cameron5906/field4-rover/docs/hardware/diagrams/01_system_architecture.png

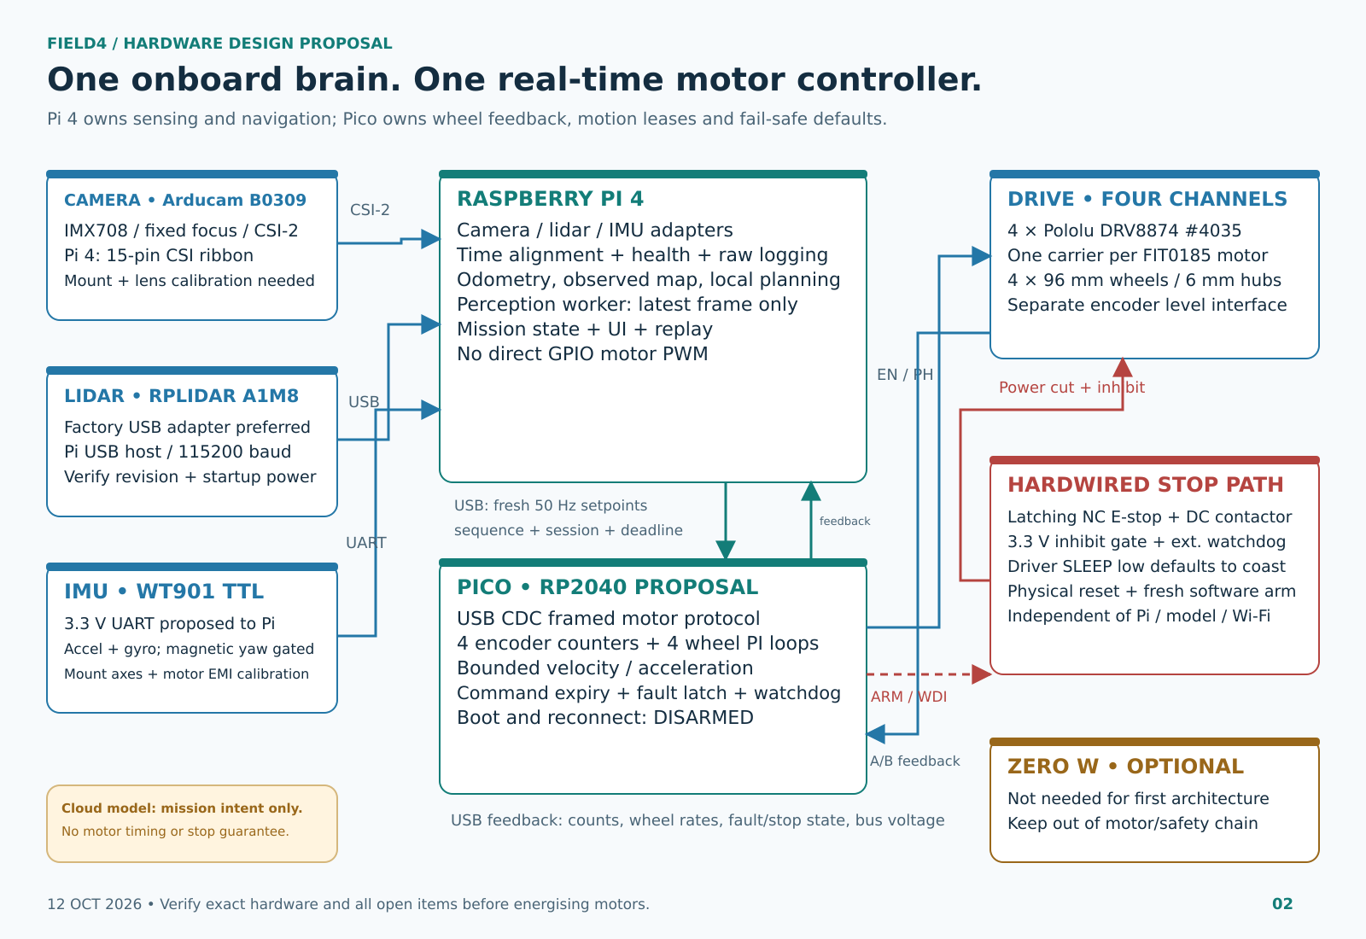
docs/hardware/diagrams/01_system_architecture.png
