cameron5906/field4-rover/docs/hardware/diagrams/02_power_and_stop.png

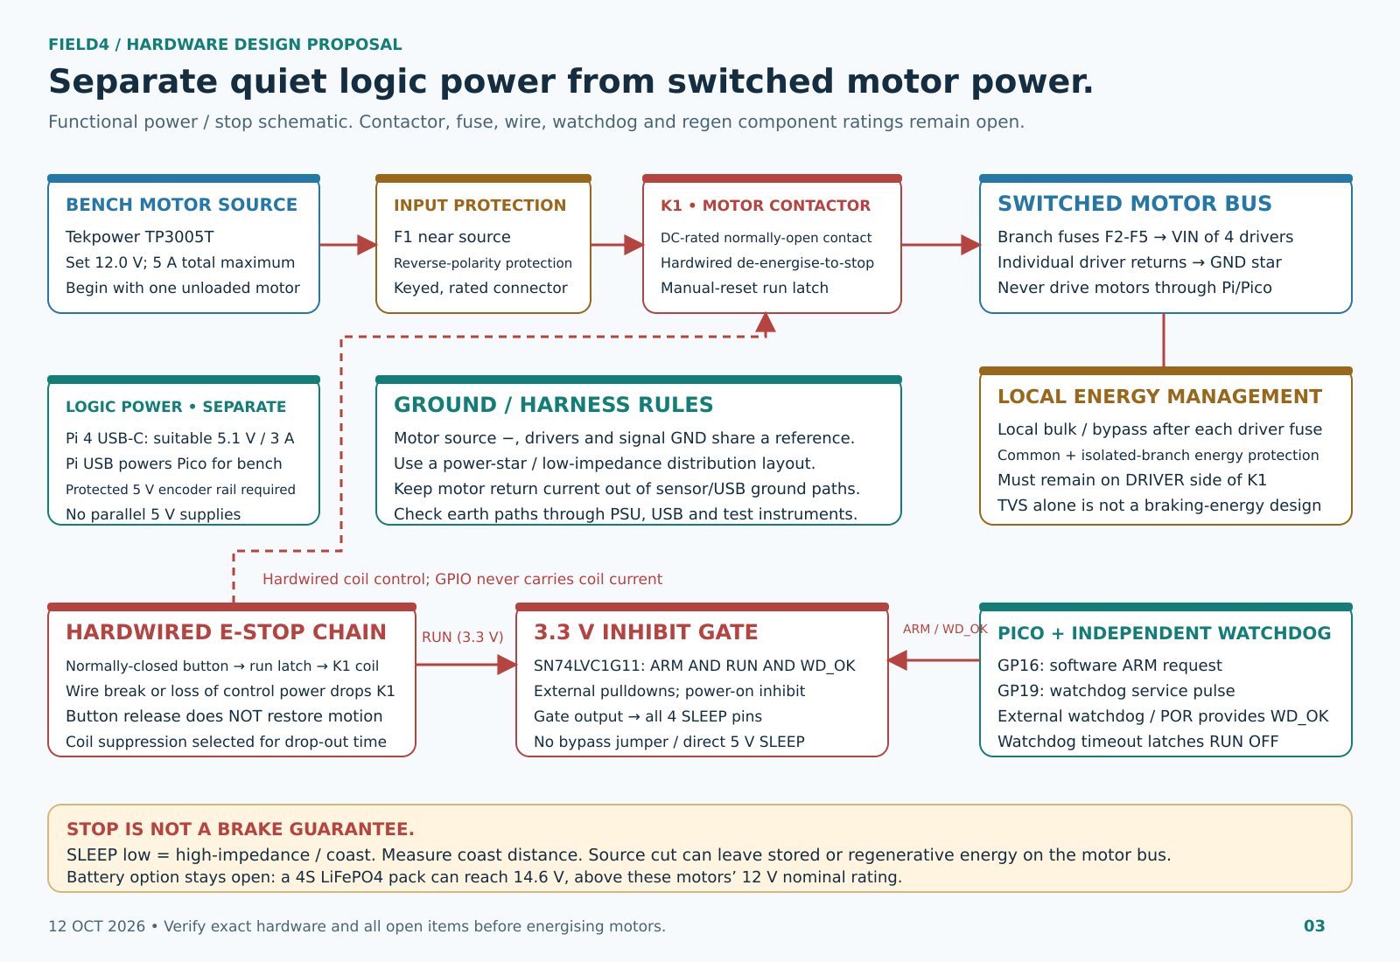
docs/hardware/diagrams/02_power_and_stop.png
