cameron5906/field4-rover/docs/hardware/diagrams/03_pinmap_and_motor_cell.png

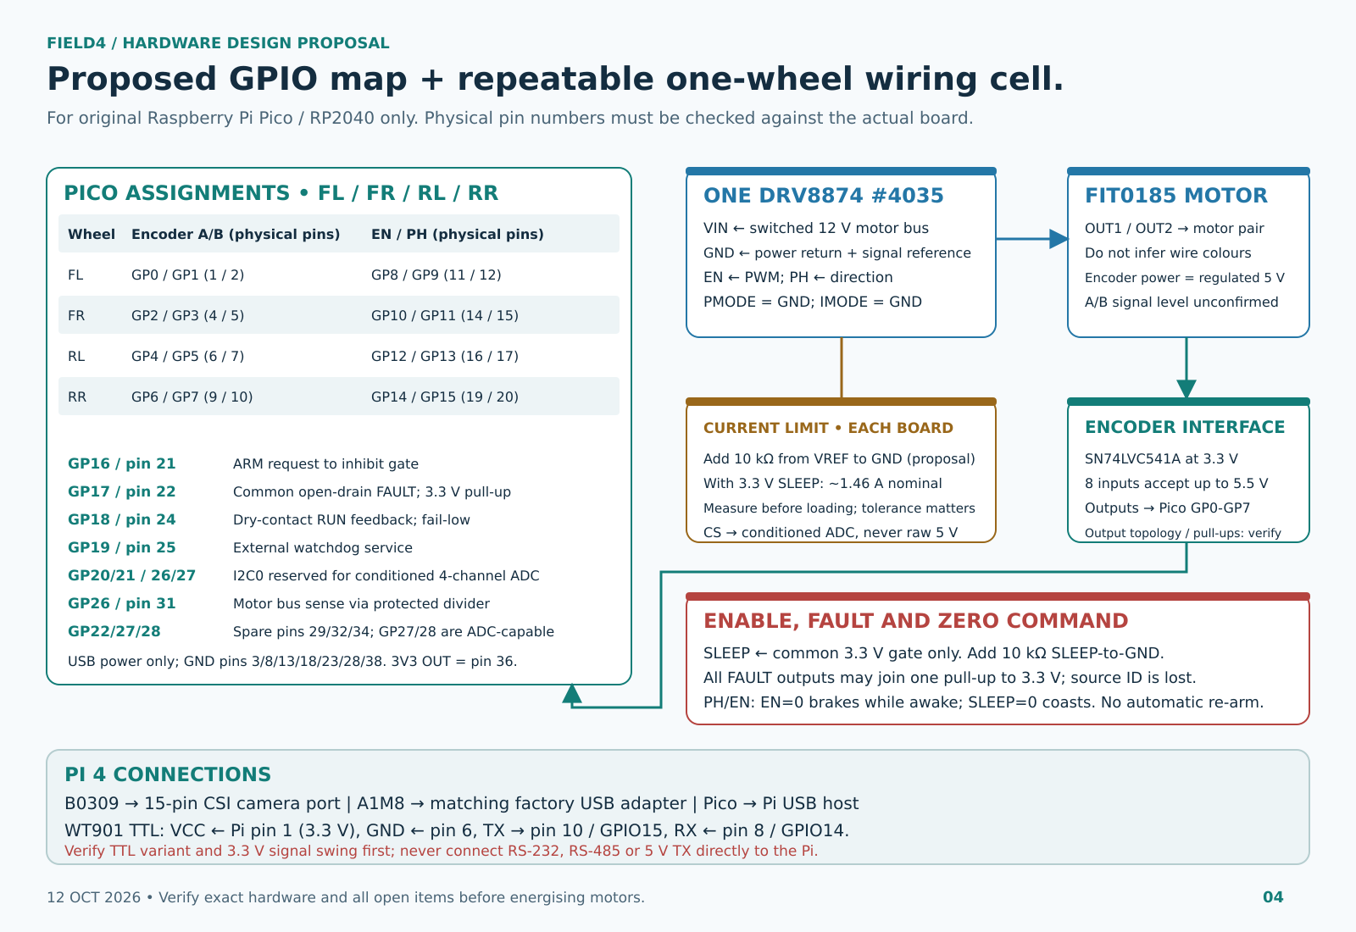
docs/hardware/diagrams/03_pinmap_and_motor_cell.png
