cameron5906/field4-rover/docs/manual/renders/electronics.png

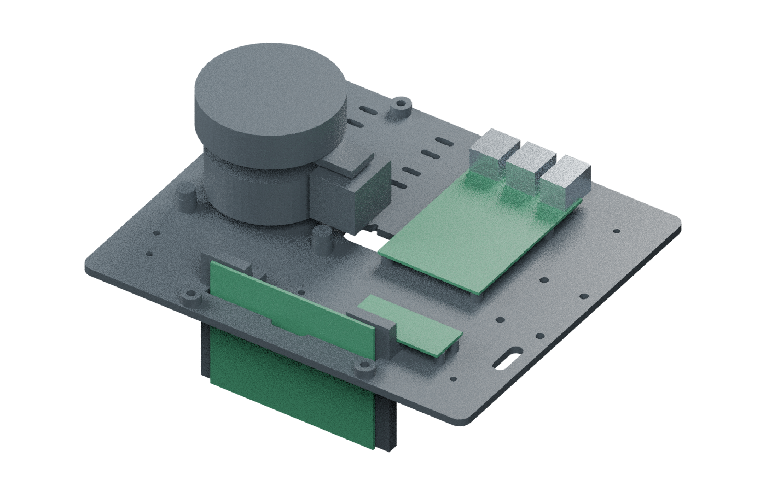
docs/manual/renders/electronics.png
