cameron5906/field4-rover/docs/manual/renders/parts.png

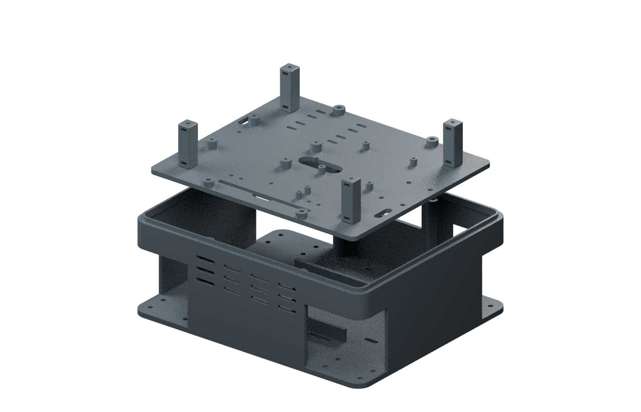
docs/manual/renders/parts.png
