cameron5906/field4-rover/cad/stl/conditional/B10_motor_mount_FR.stl

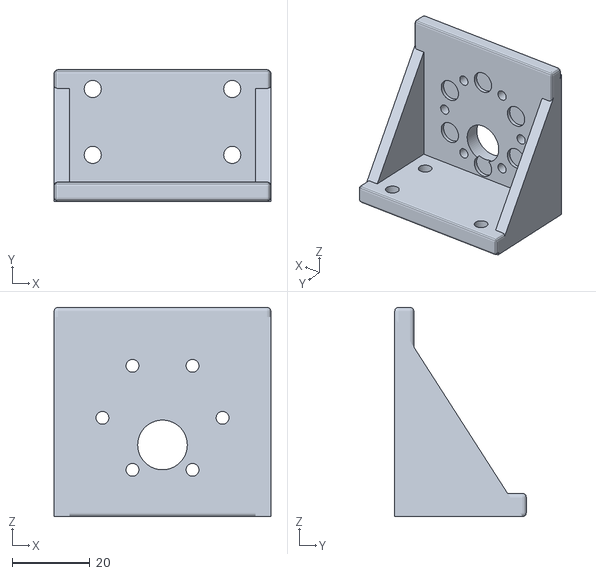
[picture p7: CAD file, 2026-10-19]
cad/stl/conditional/B10_motor_mount_FR.stl
56.0 x 34.0 x 54.0
