cameron5906/field4-rover/cad/stl/coupons/T01_motor_face_coupon.stl

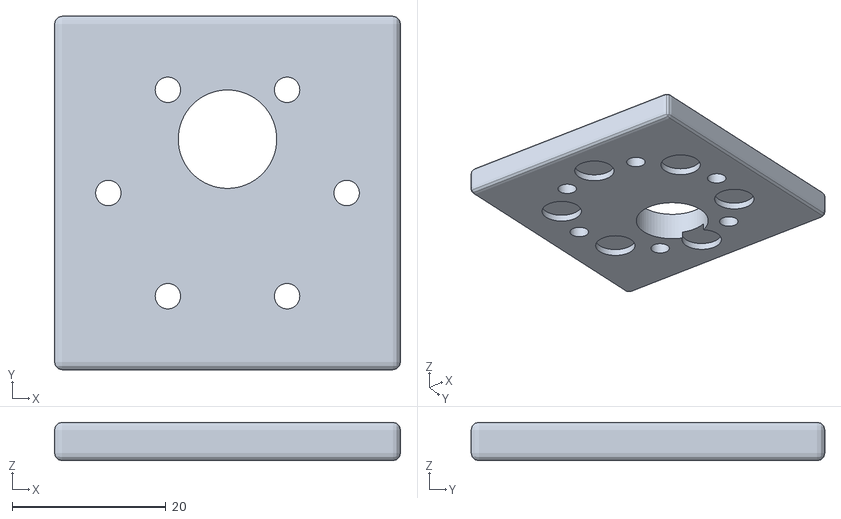
[picture p8: CAD file, 2026-10-19]
cad/stl/coupons/T01_motor_face_coupon.stl
45.0 x 46.0 x 5.00
