cameron5906/field4-rover/cad/stl/current/B05_lid_pillar_FL.stl

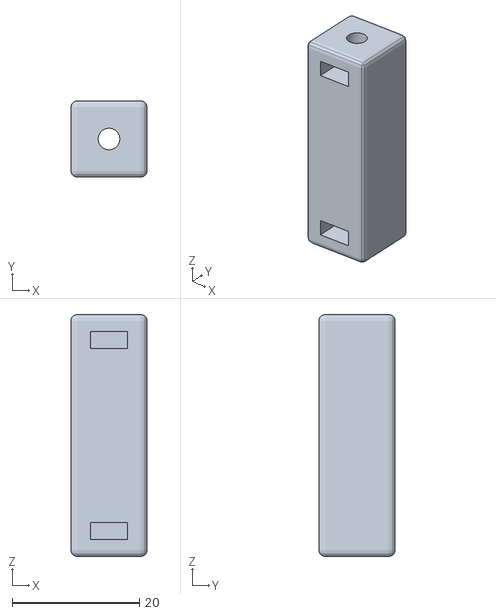
[picture p9: CAD file, 2026-10-19]
cad/stl/current/B05_lid_pillar_FL.stl
12.0 x 12.0 x 38.0
