cameron5906/field4-rover/cad/stl/coupons/T09_A1M8_four_foot_coupon.stl

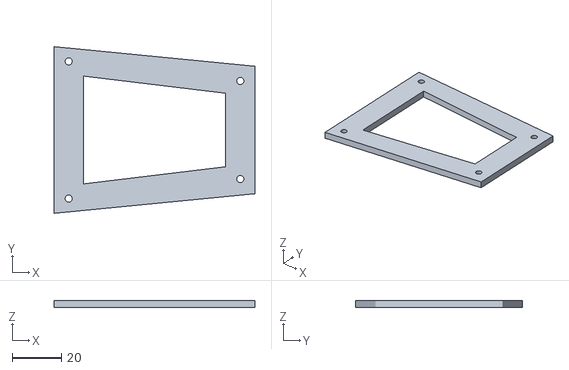
[picture p10: CAD file, 2026-10-19]
cad/stl/coupons/T09_A1M8_four_foot_coupon.stl
82.0 x 68.0 x 3.00
