cameron5906/field4-rover/cad/stl/coupons/T03_bracket_floor_coupon.stl

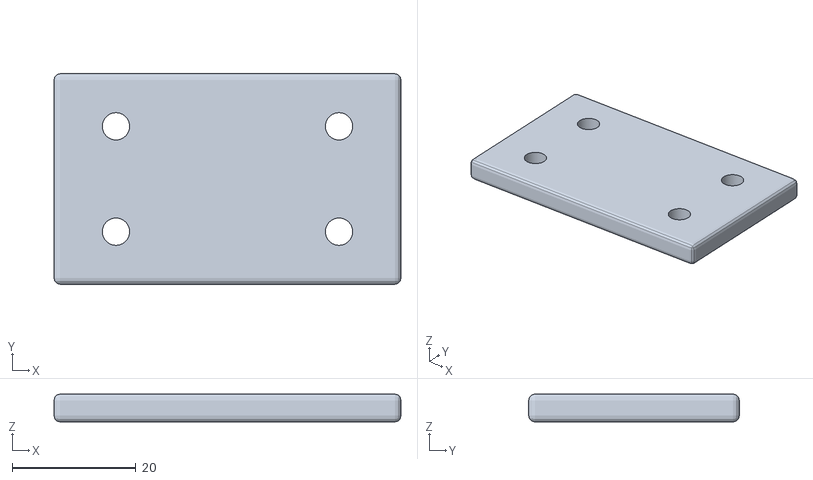
[picture p11: CAD file, 2026-10-19]
cad/stl/coupons/T03_bracket_floor_coupon.stl
56.0 x 34.0 x 4.50
