cameron5906/field4-rover/cad/stl/conditional/B07_camera_carrier.stl

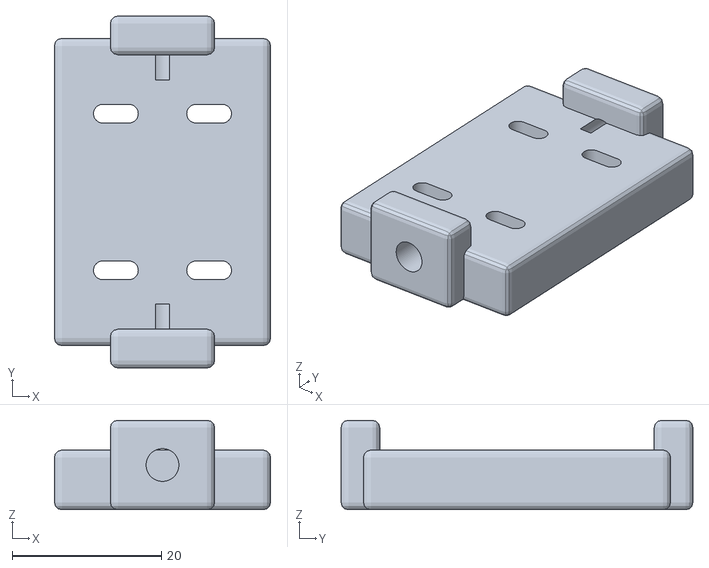
[picture p12: CAD file, 2026-10-19]
cad/stl/conditional/B07_camera_carrier.stl
29.0 x 47.2 x 12.0
