cameron5906/field4-rover/cad/stl/coupons/T07_lid_tongue_coupon.stl

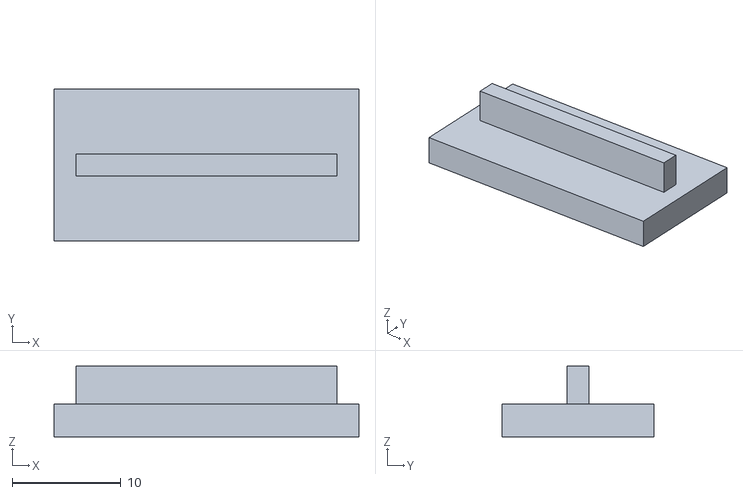
[picture p13: CAD file, 2026-10-19]
cad/stl/coupons/T07_lid_tongue_coupon.stl
28.0 x 14.0 x 6.50
