cameron5906/field4-rover/cad/stl/current/C04_A1M8_rearranged_shelf_PROTOTYPE.stl

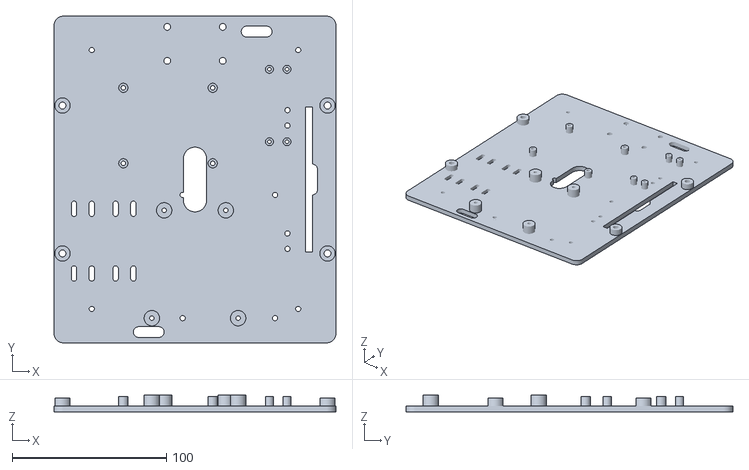
[picture p14: CAD file, 2026-10-19]
cad/stl/current/C04_A1M8_rearranged_shelf_PROTOTYPE.stl
183.0 x 212.0 x 11.0
