cameron5906/field4-rover/cad/stl/coupons/T02_fastener_clearance_coupon.stl

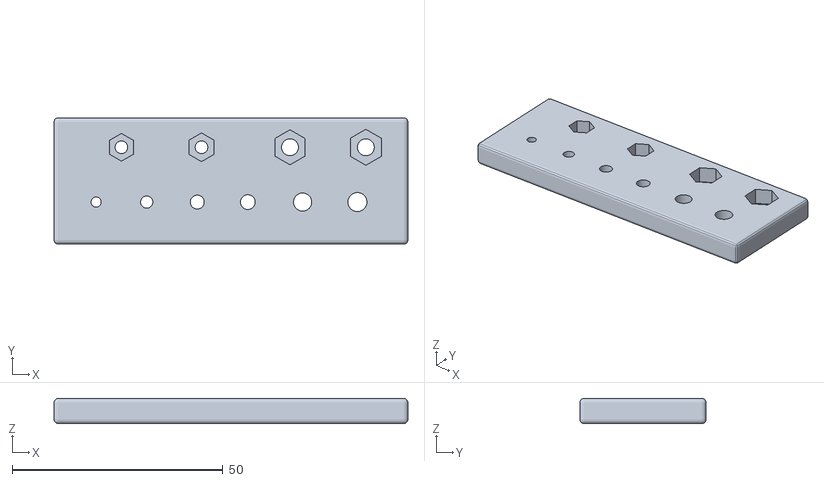
[picture p15: CAD file, 2026-10-19]
cad/stl/coupons/T02_fastener_clearance_coupon.stl
84.0 x 30.0 x 6.00
