cameron5906/field4-rover/cad/stl/current/B01_lower_tub.stl

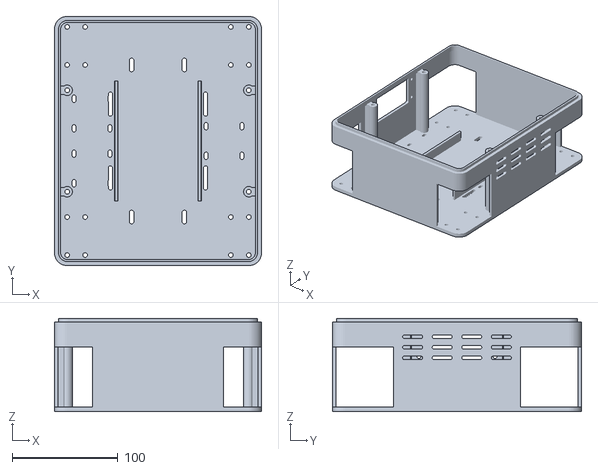
[picture p16: CAD file, 2026-10-19]
cad/stl/current/B01_lower_tub.stl
196.0 x 236.0 x 88.5
