cameron5906/field4-rover/cad/stl/conditional/C16_controller_hanger_rear.stl

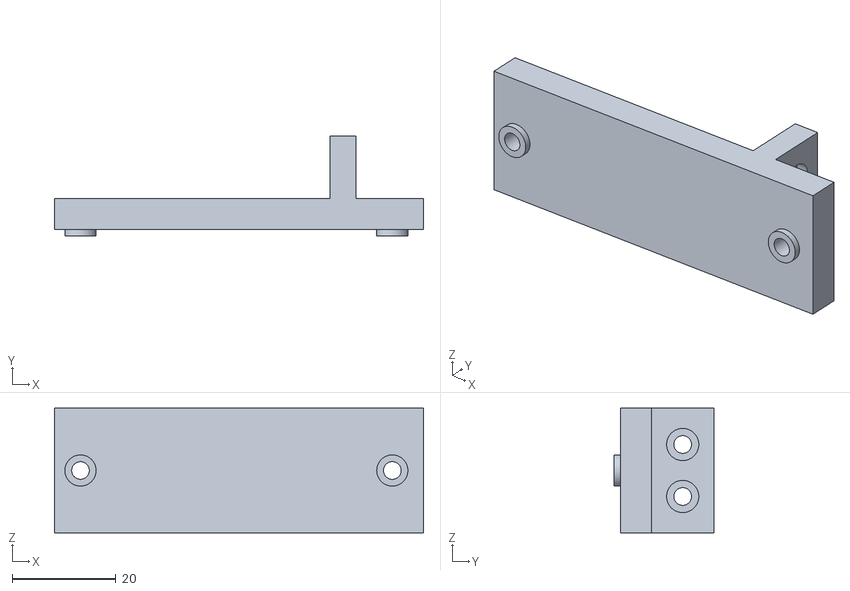
[picture p17: CAD file, 2026-10-19]
cad/stl/conditional/C16_controller_hanger_rear.stl
71.0 x 19.2 x 24.0
