cameron5906/field4-rover/cad/stl/coupons/T04_camera_pattern_coupon.stl

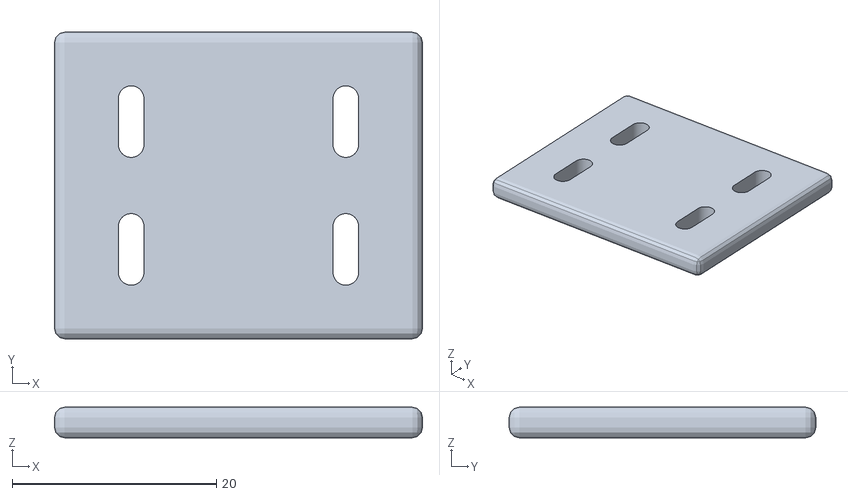
[picture p18: CAD file, 2026-10-19]
cad/stl/coupons/T04_camera_pattern_coupon.stl
36.0 x 30.0 x 3.00
