cameron5906/field4-rover/cad/stl/conditional/B06_camera_fork.stl

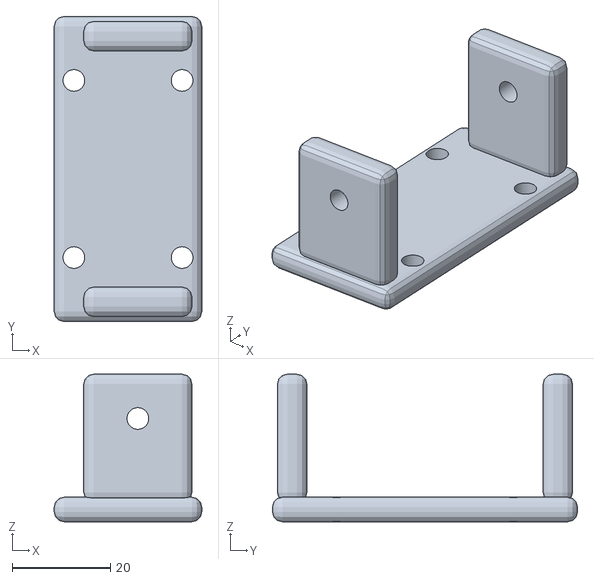
[picture p19: CAD file, 2026-10-19]
cad/stl/conditional/B06_camera_fork.stl
30.0 x 62.0 x 30.0
