cameron5906/field4-rover/cad/stl/current/B09_side_switch_panel_BLANK.stl

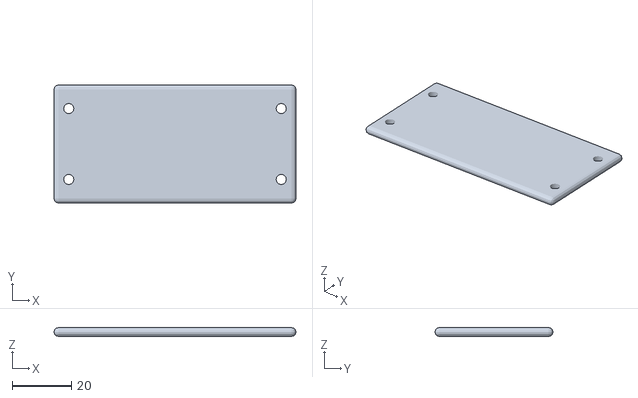
[picture p20: CAD file, 2026-10-19]
cad/stl/current/B09_side_switch_panel_BLANK.stl
82.0 x 40.0 x 3.00
