cameron5906/field4-rover/cad/stl/coupons/T06_lid_clearance_coupon.stl

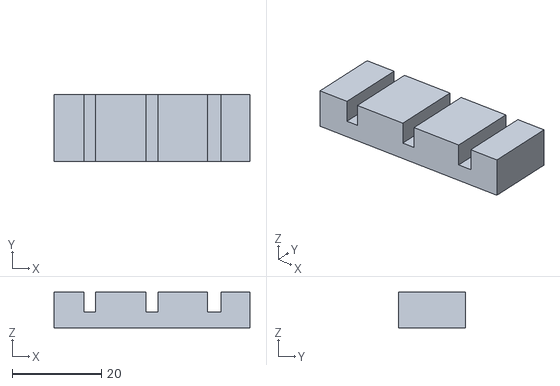
[picture p21: CAD file, 2026-10-19]
cad/stl/coupons/T06_lid_clearance_coupon.stl
44.0 x 15.0 x 8.00
