cameron5906/field4-rover/(list of files, cad)

Other CAD files:
cad/stl/conditional/B10_motor_mount_FL.stl
cad/stl/conditional/B10_motor_mount_RL.stl
cad/stl/conditional/C16_controller_hanger_front.stl
cad/FIELD4_Mechanical_Subset.blend
cad/stl/coupons/T05_M3_captive_nut_coupon.stl
