cameron5906/field4-rover/docs/manual/FIELD4_Beginner_Visual_Build_Manual.pdf

FIELD4 / BUILD MANUAL

YOUR FIRST BUILD
A robot, one clear step at a time.

FIELD4 • Recessed-LiDAR prototype • Public edition with asset holds

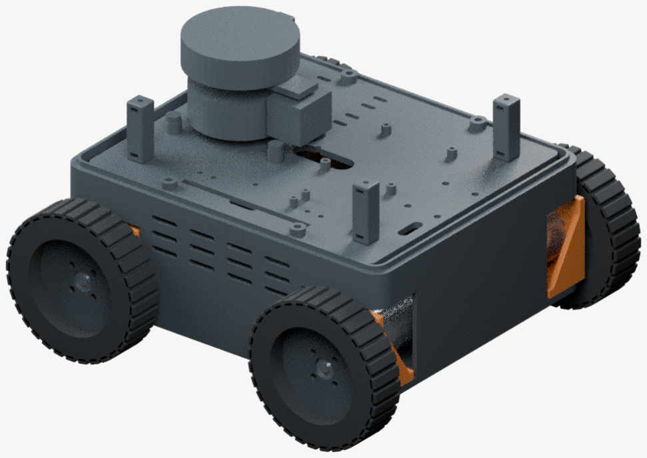
[picture p22: figure]

PROTOTYPE • Power off for every step | 01

SENSOR: SCHEMATIC PROXY / NOT FOR FIT

# A beginner-friendly mechanical build guide

Public CAD views show an open chassis and a schematic sensor. The current C02 lid and T10 aperture gauge are withheld pending reference-model redistribution clarification.

READ THIS FIRST

This public package is incomplete for the intended C02 + C04 build. Do not infer lid or aperture geometry from the pictures, or use a substitute lid. Keep all power disconnected; this prototype is uncommissioned.

Build facts retained: B01 tub + B05 pillars + B09 blank + matched C02/C04. C02 and T10 files are withheld; B08 remains excluded.

01 / PLAN YOUR SESSION

# Check what is ready

Inspect the actual parts on your bench before opening a fastener bag.

Component | Check before use | Build gate
4 Pololu DRV8874 drivers | Confirm exact board revision and condition | No wiring or mounting approval is established by this guide.
4 goBILDA 96 mm Hogback wheels + 4 Sonic 6 mm hubs | Inspect wheels, hub bores and clamp access | Verify shaft engagement and clearance with the actual motors.
Mechanical fasteners | Count and measure against page 3 | Do not infer screw length or washer thickness from appearance.
4 DFRobot FIT0185 motors | Check the actual gearbox face, shaft and lead exit | Pass the motor coupon and one-corner fit checks first.
Printed parts + A1M8 LiDAR | C02 lid and T10 gauge are withheld | The public package cannot complete the intended lid/aperture fit gates.
Battery, power protection and wiring | Electrical design is uncommissioned | Do not connect any power source.

TODAY’S STOPPING POINT

Prepare only the available power-off mechanical checks. C02 lid and T10 gauge are withheld; stop at any dependent step. Keep the shelf removable and do not improvise a replacement lid or aperture.

02 / SORT THE HARDWARE

# Make five small parts trays

Required quantities for these mechanical joints only; other assemblies need separate checks.

Tray / job | Required for this build | Reference SKU
LiDAR final mount | 4 M2.5×16 screws + 4 M2.5 thin flat washers | MSP2.5X16SS WF2.5X5SS
Shelf to tub | 4 M4×100 SOCKET-head screws + 8 M4 flats + 4 M4 split washers + 4 M4 plain nuts | BSH4X100 WF4X8SS WL4SS; NR4SS
Pillars + lid | 8 M3×12 button screws + 8 M3 plain nuts; no flat washers in these stacks | SB3X12SS NR3SS
Switch BLANK | 4 M3×12 button screws + 8 M3 thin flats + 4 M3 plain nuts | SB3X12SS; NR3SS WF3X6SS
Shared M3 totals | 12 M3×12 screws + 12 M3 plain nuts across the two jobs above | Verify actual sizes before assembly

The three specified thin flat-washer sizes are 0.5 mm thick. Flat washer = smooth ring. Split washer = ring with a split. Plain nut = no nylon locking ring. Do not substitute taller locking nuts in printed pockets. SKU references identify BelMetric parts; verify specifications before use.

ADDITIONAL HARDWARE REQUIRED

T09 needs separate M2.5×6 screws; they are not in the list above. Motor, wheel, electronics, controller-hanger and camera fasteners also require separate verification.

03 / LEARN THE PARTS

# This is how the body fits together

Exploded public parts view. The intended C02 lid is withheld and not shown.

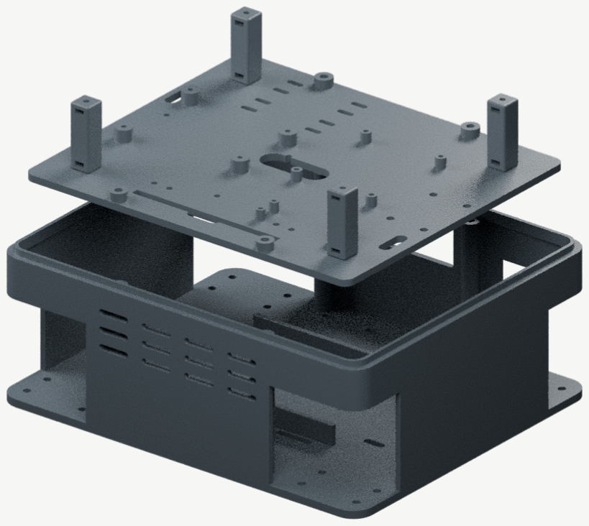
[picture p23: figure]

SHOWN: four B05 pillars + C04 shelf → B01 tub. C02 lid is withheld.

1. The intended C02 lid is removable; its file is withheld. The LiDAR and shelf are carried by the lower body rather than the lid.
2. FL / FR / RL / RR mean front-left / front-right / rear-left / rear-right, as the robot faces forward. Front is the camera end; the LiDAR sits toward the rear.
3. C02 and C04 remain the intended matched pair, but C02 is not distributed here. Do not substitute older B02/B04 parts or invent a lid from this illustration. Leave B08 out.

BEGINNER TIP

Lay out labeled parts before fastening them. A dry fit means putting parts together gently, without power and without fully tightening screws.

04 / PREPARE

# Get the bench ready

Keep small screws in trays. Put electronics on a clean, nonconductive surface.

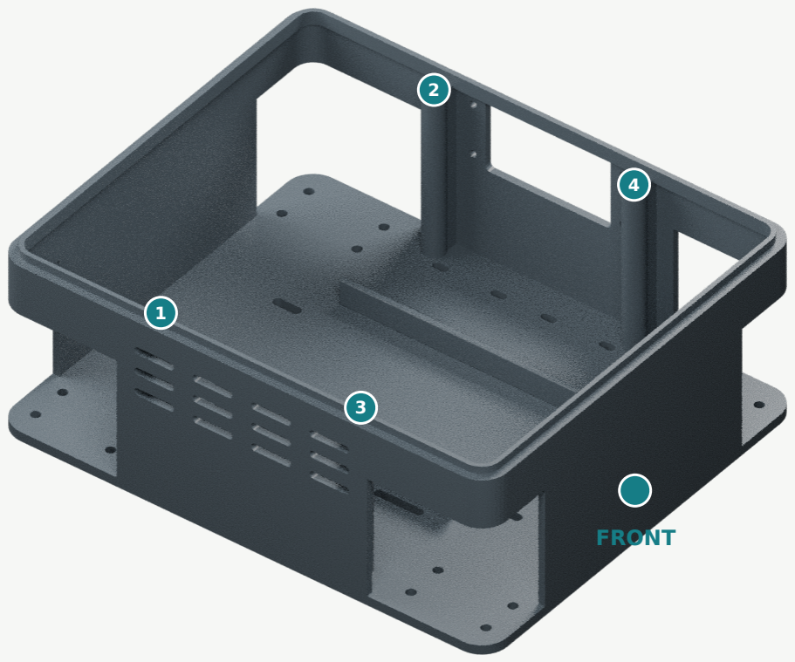
[picture p24: figure]
FRONT

1. Gather a ruler or caliper, the correct-fit hex keys and screwdriver for your screws, 5.5 mm (M3 nut) and 7 mm (M4 nut) spanners, deburring tool, and eye protection when removing supports. Do not use a power driver.
2. Remove print supports and loose strings. Inspect the B01 tub, shelf seats, rim and screw holes. Stop for cracks, missing layers or visible warping.
3. Use T02 for fastener clearance and T05 for captive-nut fit first. Screws should start by hand. If a hole or nut pocket is too tight, stop and correct the print; do not force metal into plastic.

PRINTING CHECK

Import supplied STL files in millimetres at 100%. C04 shelf: 183 × 212 × 11 mm. Intended C02 lid: 196 × 236 × 43 mm, but its file is withheld. Check print orientation, supports and the actual slicer profile.

05 / TEST BEFORE LARGE PRINTS

# Check the LiDAR fit first

The public T09 gauge checks the feet. The T10 aperture gauge is withheld.

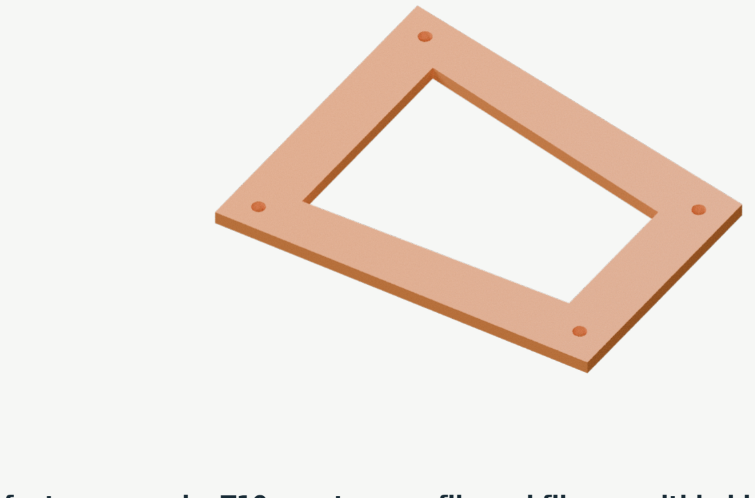
[picture p25: figure]

T09 four-foot gauge only. T10 aperture profile and file are withheld.

1. T09: rest the four fixed sensor feet on the frame. All four holes must line up without bending the feet. For a screw-fastened check, use M2.5×6 with the specified 0.5 mm washers.
2. T10 is withheld pending reference-model redistribution clarification. Its intended check is vertical clearance around the rotating head and belt/pulley extension. Do not improvise that profile or force a gauge past optics or the belt.
3. Check the actual A1M8 revision. A matching product name alone does not prove that its feet and body match this model.

STOP: DO NOT USE THE LONG SCREWS

M2.5×16 is for the final 11 mm shelf/seat stack only. Through the 3 mm T09 coupon it can damage the sensor. If the short screws are missing, do only a gentle no-screw alignment check; the fastened check is still pending.

06 / BUILD THE SHELF SUBASSEMBLY

# Fit the four lid pillars

Parts: C04 shelf + B05 FL, FR, RL, RR • Hardware: 4 M3×12 + 8 plain M3 nuts

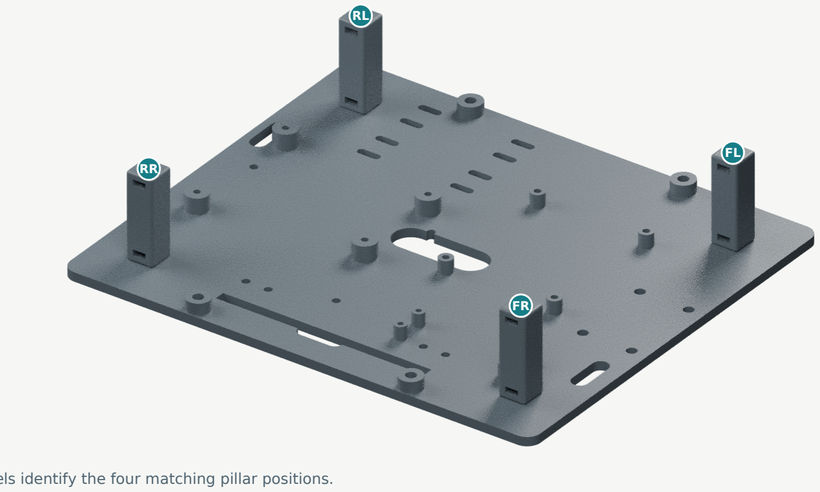
[picture p26: figure]

Labels identify the four matching pillar positions.
1. Place one ordinary M3 nut into the pocket at each end of every B05 pillar: eight nuts in total. Each nut must sit fully in its pocket and line up with the screw hole.
2. Put the labeled pillars in the matching shelf corners. Start four M3×12 screws upward from below the shelf into the bottom pillar nuts. No washers are specified for this stack.
3. Tighten gently with a hand tool, just until seated. Keep the upper nuts free for the lid screws. Plastic should not bow or whiten.

CHECK BEFORE MOVING ON

All four pillars stand square. Nuts do not spin. Every screw starts easily by hand. If a nut will not seat, fix the printed pocket rather than substituting a taller nyloc nut.

07 / CLOSE THE UNUSED OPENING

# Fit the side switch blank

Parts: B09 BLANK • Hardware: 4 M3×12 + 8 thin M3 flat washers + 4 plain M3 nuts

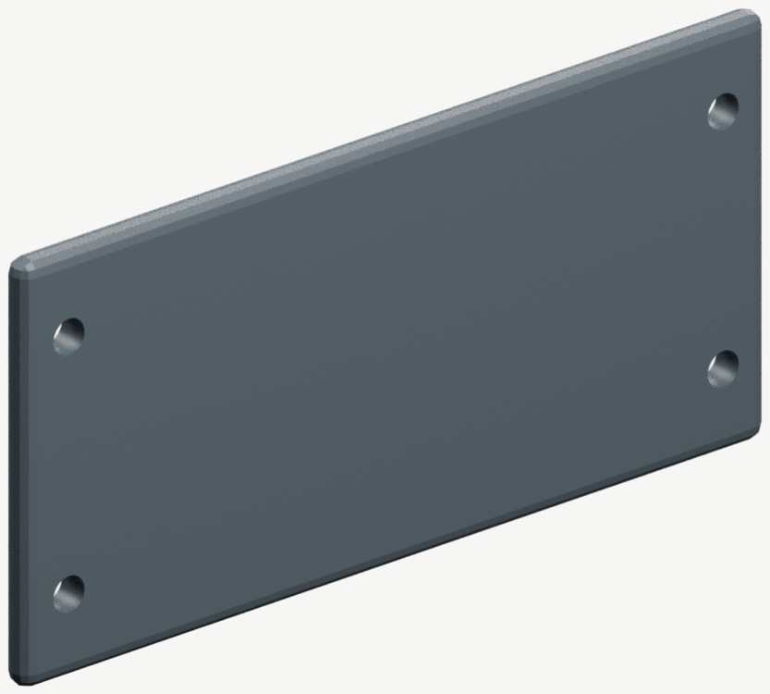
[picture p27: figure]

1. Find the matching side-panel opening and hold B09 against it. The panel is a blank adapter, not an installed electrical switch.
2. Use four M3×12 screws. Fit this before installing the shelf, while you can reach both sides. Each joint uses a flat washer under the head and another under the plain nut. Start all four before tightening.
3. Check that the panel sits flat and no screw tail touches a future wire route. Keep the blank unmodified until a real switch and its cutout/panel requirements are confirmed.

NO SWITCH CUTOUT YET

Do not drill a guessed hole from a model or generic part list. The specified hardware fastens the blank only; it does not establish switch fit or make the power system ready.

08 / MOUNT THE LIDAR
Sensor above. Screws below.

Only after the coupon checks pass • Hardware: 4 M2.5×16 + 4 specified thin flat washers

SENSOR: SCHEMATIC PROXY / NOT FOR FIT

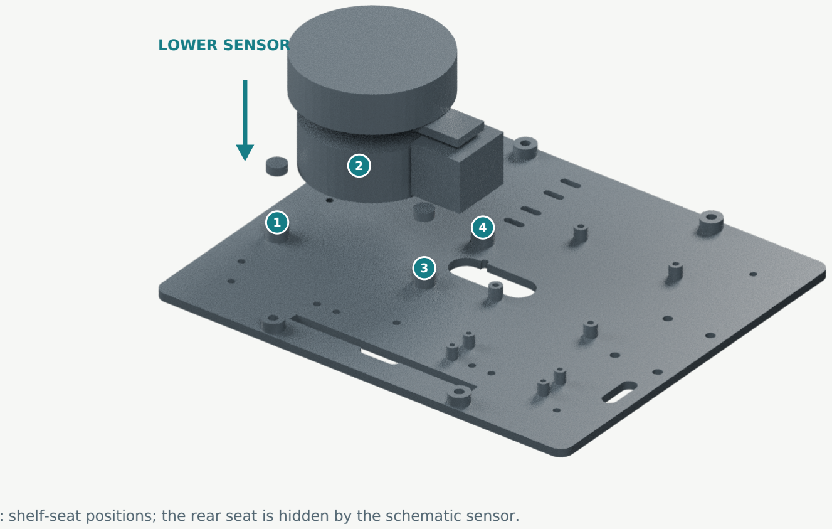
[picture p28: figure]
LOWER SENSOR

1-4: shelf-seat positions; the rear seat is hidden by the schematic sensor.
1. Set the LiDAR’s four fixed feet onto the four C04 seats. In the model, its motor/belt extension points toward the front (camera end). The rotor is toward the rear.
2. Support the shelf safely without resting the sensor on its optics. From below, put a thin washer on each M2.5×16 screw, then start each screw into a sensor foot by hand.
3. Measure the real stack before tightening. Nominally: 4 mm shelf + 7 mm boss + 0.5 mm washer leaves 4.5 mm engagement into a 6 mm-deep thread. Hand-snug only; never bottom a screw.

CHECK BEFORE MOVING ON

All four feet rest flat. Screws do not reach moving parts or the PCB. Route the sensor cable below the roof and away from the rotor/belt, with slack for service. Never hang the shelf by a cable.

09 / SEAT THE SHELF

# Lower the shelf onto the tub

Hardware: 4 M4×100 socket heads + 8 thin flats + 4 split washers + 4 plain M4 nuts

SENSOR: SCHEMATIC PROXY / NOT FOR FIT

ONE SHELF JOINT

Head

Flat

Printed stack

Flat
Split

Plain nut

SCHEMATIC / NOT TO SCALE

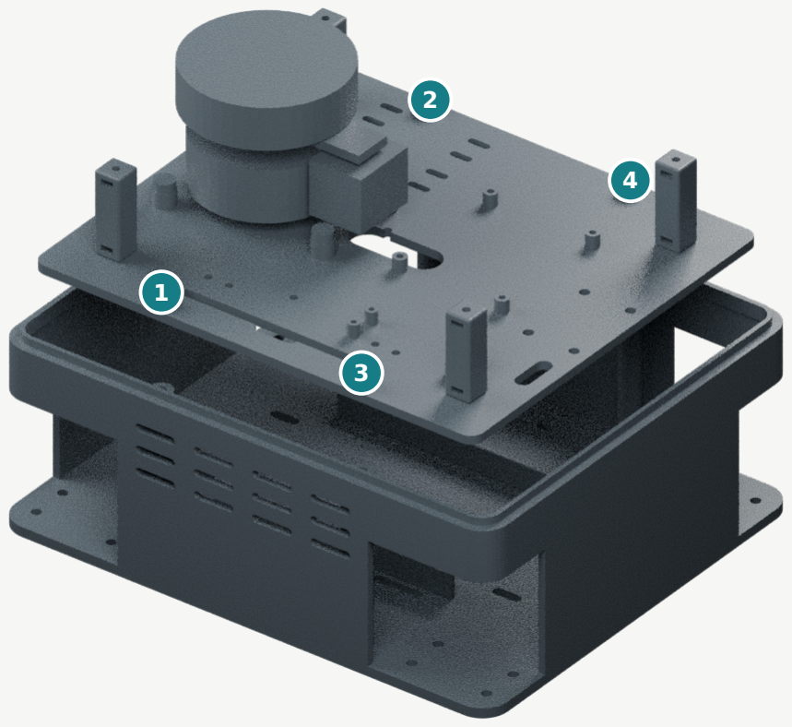
[picture p29: figure]

1-4: long-bolt seats • Enlarged gap shows lowering direction.
1. First check the space below the shelf. Leave out the B08 buck platform and any unapproved battery/power hardware. Lower the shelf straight onto its four tub seats.
2. At each fixing: socket-head screw → upper flat washer → printed shelf/seat stack → lower flat washer → split washer → plain M4 nut. The screws point downward.
3. Start all four joints loosely, then tighten gently and evenly. Measure the actual split-washer stack; do not assume it fully flattens. Confirm the nut is on the fully threaded section and at least two full threads protrude, and that nuts/tails do not compromise ground clearance.

IMPORTANT CLEARANCE CHECK

Tighten these bolts before connecting Pi plugs. A long-bolt head overlaps a modeled Pi plug/cable space. Check your actual plugs, cables and tool access; do not assume a rendered connector proves fit.

10 / LID STEP ON HOLD

# C02 is withheld

Retained assembly facts only. The public files do not complete this step.

# C02 LID + T10 GAUGE

## Files and affected illustrations withheld

Reference-model redistribution needs clarification. No replacement aperture or printable lid geometry is supplied. Do not derive a fit design from the sensor proxy or this manual.

The checks below preserve the intended build requirements; they are not permission to bypass the missing parts or fit gates.

1. If an appropriately cleared C02 reference becomes available, keep power disconnected and cables clear; lower it vertically over the sensor. Do not tilt it or push against the rotor, belt extension or camera area.
2. Confirm the lid seats on its rim without force. The sensor is carried by the shelf, not by the roof. The modeled lower edge of the rotating head is only 1.5 mm above the roof: check the actual clearance.
3. If it fits, start four M3×12 lid screws from above into the upper pillar nuts. No washers are specified. Hand-snug only. Remove and replace the lid once to prove a clear vertical service path.

STOP IF IT TOUCHES

Any rubbing, pinched cable or forced fit means stop and correct the fit. Do not use the lid screws to pull a warped or obstructed lid down. Never lift the robot by this cover.

11 / ELECTRONICS FIT GATE

# Keep this area provisional

The model places boards; it does not prove wiring, electrical design or actual board mounting.

SENSOR: SCHEMATIC PROXY / NOT FOR FIT

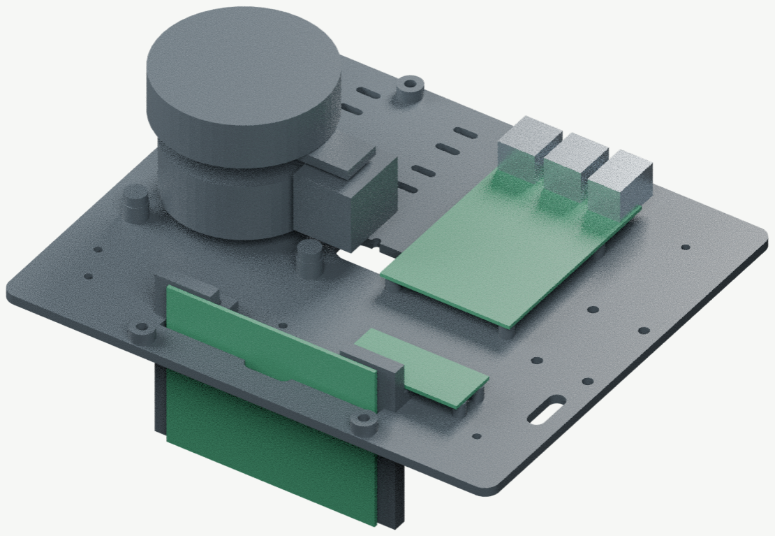
[picture p30: figure]

1. The Pi and Pico shelf bosses are integral. Do not stack extra standoffs on top without rechecking the design. Check actual board undersides, insulating washers and connector clearances.
2. Two C16 hangers are conditional. They assume a 90 × 70 mm carrier with 80 × 60 mm hole pitch, not a ready-made mounting pattern for four loose DRV8874 boards.
3. C16 hardware, camera fasteners and IMU mounting are outside the page 3 list. Check the actual camera/carrier fit and cable route. Leave these installations pending if unverified.

DO NOT POWER IT

Battery, fuses/protection, E-stop, driver current limits, encoder voltage compatibility, safe boot and loss-of-command behavior are unresolved. No wiring diagram or powered test is approved by this manual.

12 / CONDITIONAL: MOTOR INSTALLATION

# Test one motor and bracket first

Conditional sequence • Verify the suggested hardware and actual component fit before assembly.

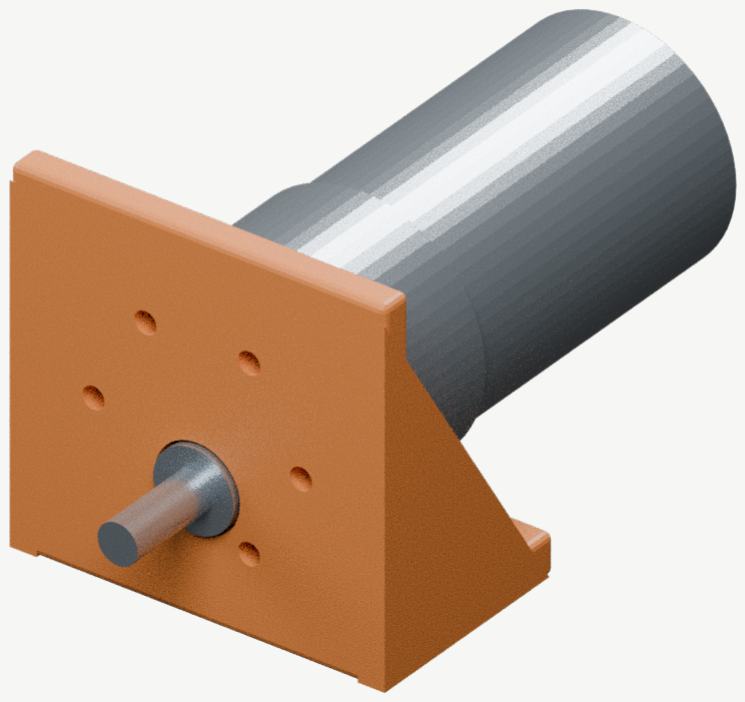
[picture p31: figure]

1. Start with the T01 motor-face coupon. Check the six M3 positions, gearbox boss, offset shaft and relief for the factory screw heads. The relief side faces the gearbox. Stop if the face does not sit flat.
2. For each B10 mount, the design calls for six M3×8 with approximately 0.5 mm washers through a 5 mm face: nominal 2.5 mm insertion, versus the stated 3 mm maximum. Measure the actual motor and stack; never probe depth with a long screw.
3. Bracket-to-tub fixings were specified as M4×20 upward from below, washers and locking nuts above the feet. Verify the exact required hardware and real tool clearance before proceeding.

WAIT FOR THE REAL MOTOR

The rendered motor is simplified. Its encoder, connector and lead exit may differ. Confirm rear clearance, screw-head/tire clearance and lead routing before repeating the assembly at all four corners.

13 / LATER: WHEELS AND HUBS

# Clamp the hub before the wheel

Check final shaft fit using the actual wheels, hubs and motors.

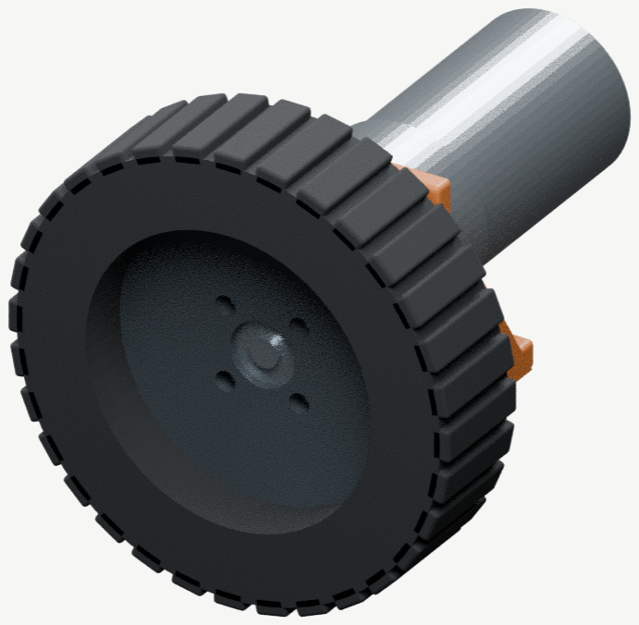
[picture p32: figure]

1. Fit a Sonic 6 mm round-bore hub onto the 6 mm D shaft. The model targets its back face 9.5 mm outward from the gearbox face. Verify actual shaft engagement and use the hub maker’s tightening instructions.
2. Keep the hub pinch bolts reachable and clamp the hub before fitting the wheel. The wheel’s 8 mm inset side faces the motor. Do not guess torque or add improvised shims.
3. Suggested design hardware: four M4×10 per wheel with approximately 0.8 mm washers through the 4 mm web, giving nominal 5.2 mm hub engagement. This hardware is outside the page 3 list; verify actual screws do not bottom or foul.

POWER-OFF SPIN CHECK

Rotate each wheel by hand through a full turn, with a light side load. Check the tire against every screw head, washer, bracket and shell edge. Any rubbing or flex-related contact is a stop.

14 / FINAL MECHANICAL CHECKPOINT

# Stop here, then review

A tidy dry build is progress. It is not yet a commissioned robot.

Check | Pass / hold
Correct C02 + C04 pair; B08 absent; no old B02/B04 mixed in | ________
No cracks, warped seating faces or forced fasteners | ________
LiDAR coupon checks passed; real screw projection measured | ________
Four feet seated; rotor/belt/optics clear; cables restrained safely | ________
Shelf stack verified; plain nuts engaged; ground/tool/plug clearance checked | ________
Lid lowers and lifts vertically without touching anything | ________
Motor/wheel steps deferred until actual motor + hardware checks pass | ________
Battery and all power sources remain disconnected | ________

If something fails: stop, photograph the part and screw stack, and record the part ID and measured dimension. Do not force the fit, drill a sensor, bottom a gearbox screw or change electrical settings to compensate.

NEXT BUILD SESSION

Resolve the withheld C02/T10 references and missing hardware/fit checks before completing the intended build. A reviewed power/wiring design is required before powered tests. The Windows simulator is not ready-to-run Pi firmware.

REFERENCE / WHAT THIS GUIDE IS BASED ON

# Model and evidence notes

Use these notes when a physical part differs from the picture.

Selected geometry

The intended build pairs C02 recessed A1M8 lid with C04 rearranged shelf, retaining RevB B01, B05 and B09. C02 and T10 aperture-gauge files and affected illustrations are withheld pending reference-model redistribution clarification. B02/B04 remain superseded; B08 is excluded.

Public illustrations

Public illustrations omit the withheld C02 lid and T10 gauge. The sensor is an original simple geometric proxy, not manufacturer CAD, an exact outline, or evidence of fit. No generic placeholder is a printable replacement or a redesigned engineering part.

Fit and fastener limits

Dimensions and screw stacks are nominal design values. Verify all actual component revisions, printed dimensions, engagement depths, washer thicknesses, tool access and clearances. Pass the coupons before larger prints. No physical fit, strength, thermal, vibration or wiring tests are certified by this guide.

Mechanical scope only

The guide covers a power-off mechanical prototype. Electronics mounting and all power-system decisions remain conditional or unresolved. Do not use a picture, simulator or hardware list as electrical commissioning approval.

Use the makers’ instructions

Confirm current component instructions and actual revisions before the conditional drivetrain steps. Manufacturer reference sites: slamtec.com/en/support • dfrobot.com/product-633.html • gobilda.com • pololu.com. These references do not endorse unverified substitutions.

Public beginner mechanical guide v1 • Dimensions are nominal millimetres unless stated otherwise.
