cameron5906/field4-rover/docs/history/rev-b/sleek_assembled.png

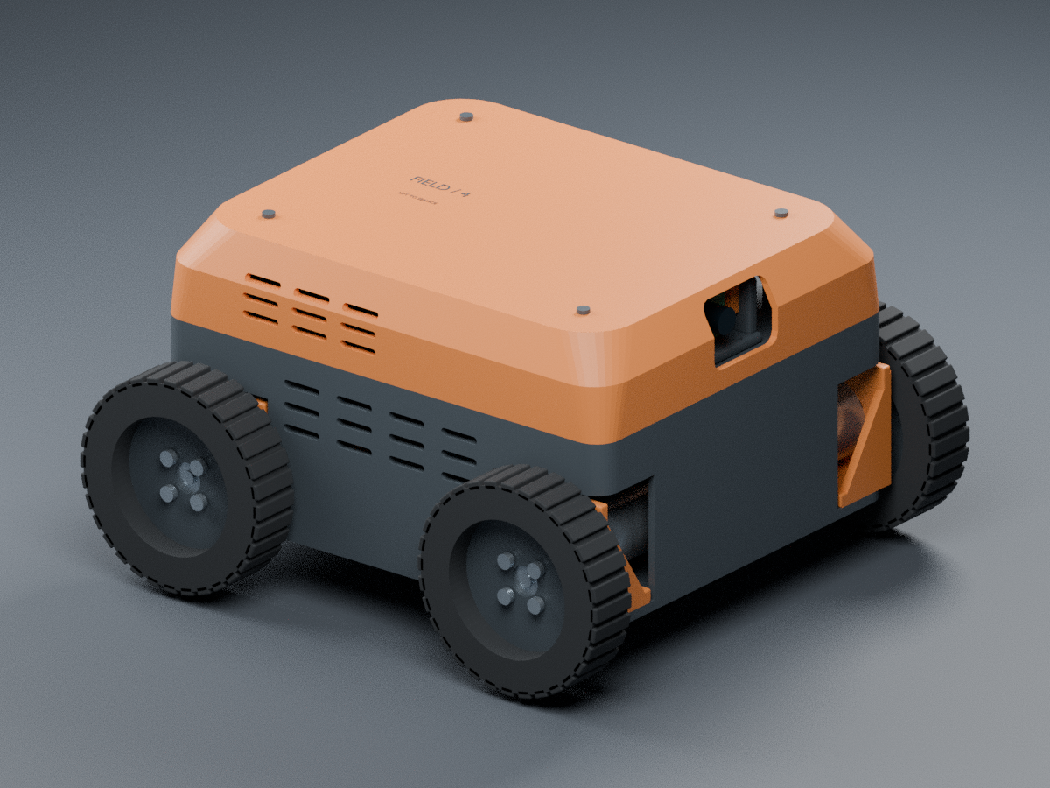
docs/history/rev-b/sleek_assembled.png
