cameron5906/field4-rover/docs/manual/renders/blank.png

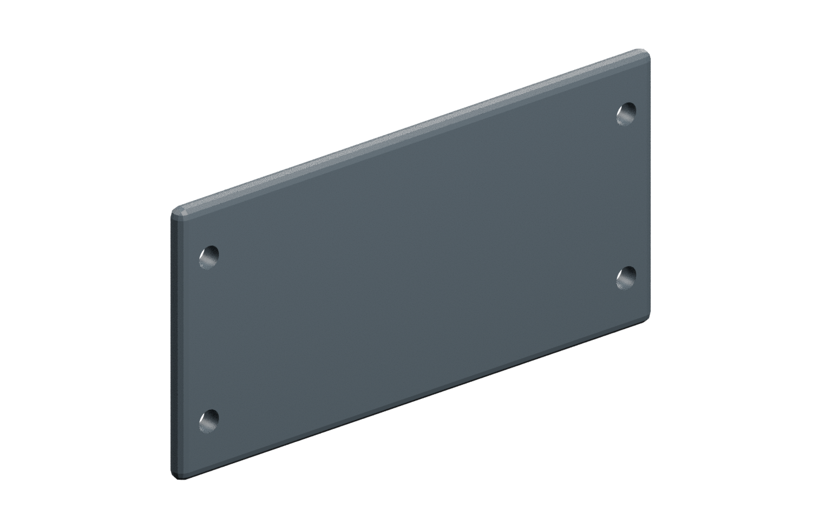
docs/manual/renders/blank.png
