cameron5906/field4-rover/docs/manual/renders/coupons.png

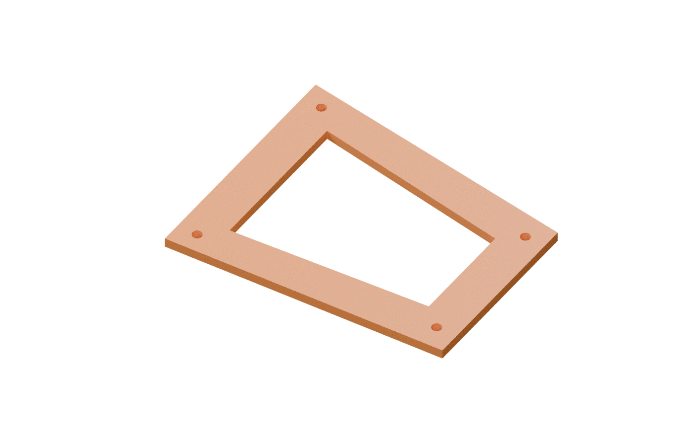
docs/manual/renders/coupons.png
