cameron5906/field4-rover/docs/manual/renders/lower.png

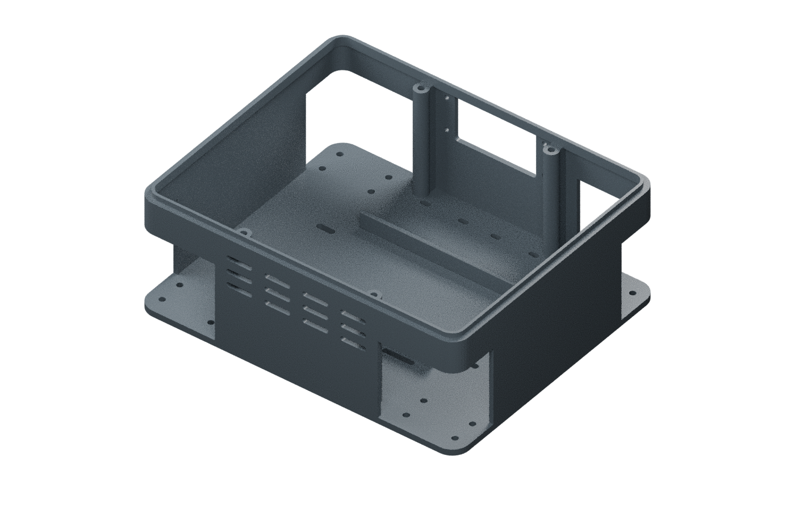
docs/manual/renders/lower.png
