cameron5906/field4-rover/docs/manual/renders/motor.png

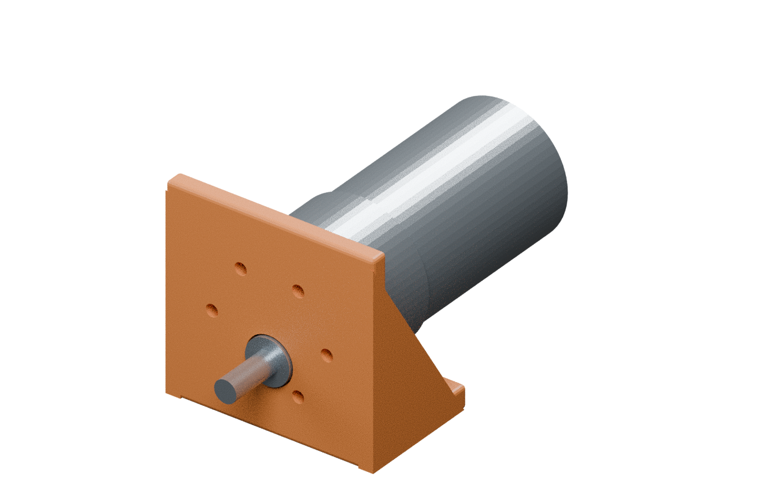
docs/manual/renders/motor.png
