cameron5906/field4-rover/docs/manual/renders/orientation.png

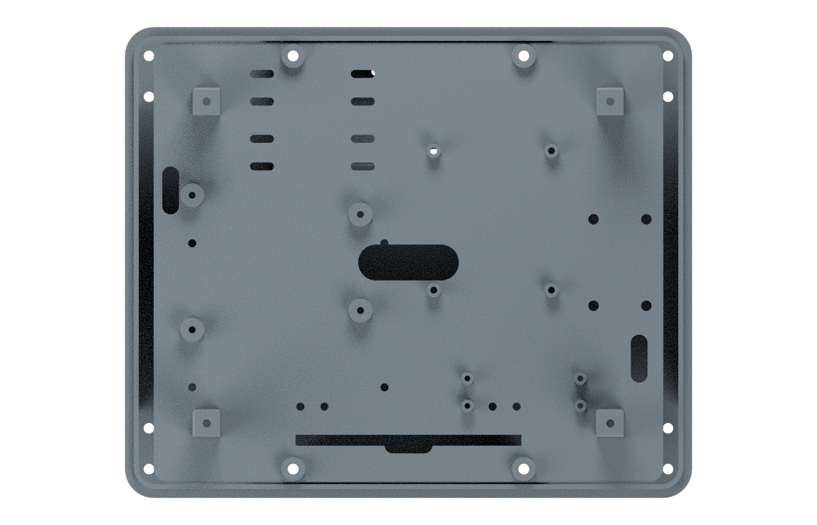
docs/manual/renders/orientation.png
