cameron5906/field4-rover/docs/manual/renders/pillars.png

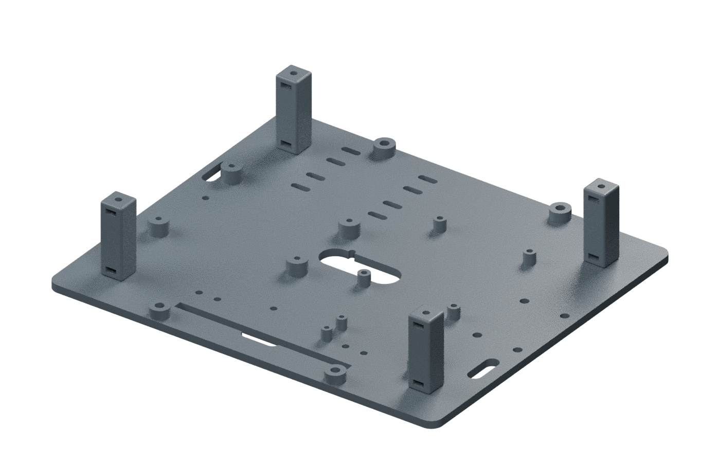
docs/manual/renders/pillars.png
