cameron5906/field4-rover/docs/manual/renders/sensor.png

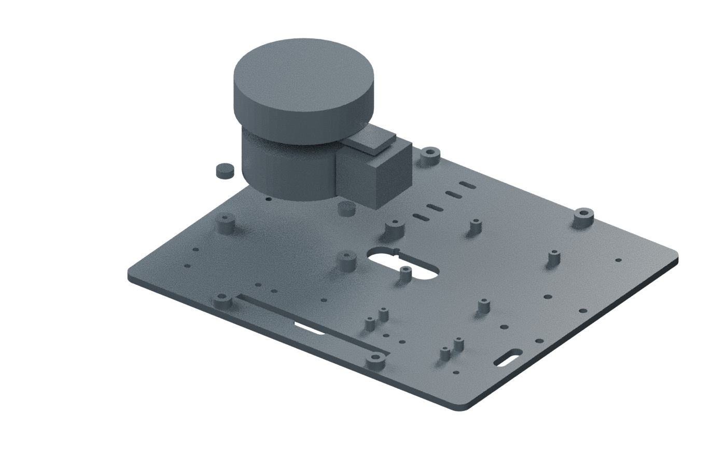
docs/manual/renders/sensor.png
