cameron5906/field4-rover/docs/manual/renders/shelf.png

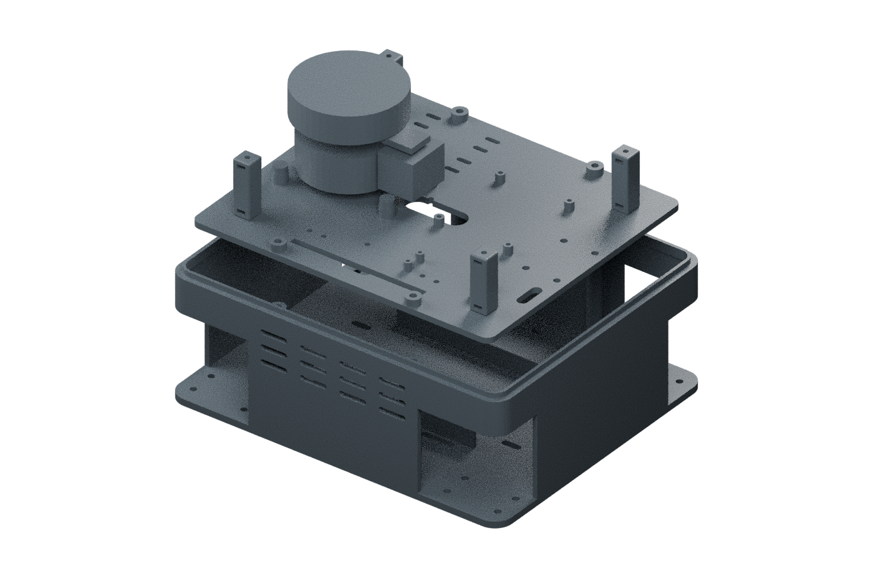
docs/manual/renders/shelf.png
