cameron5906/field4-rover/docs/manual/renders/wheel.png

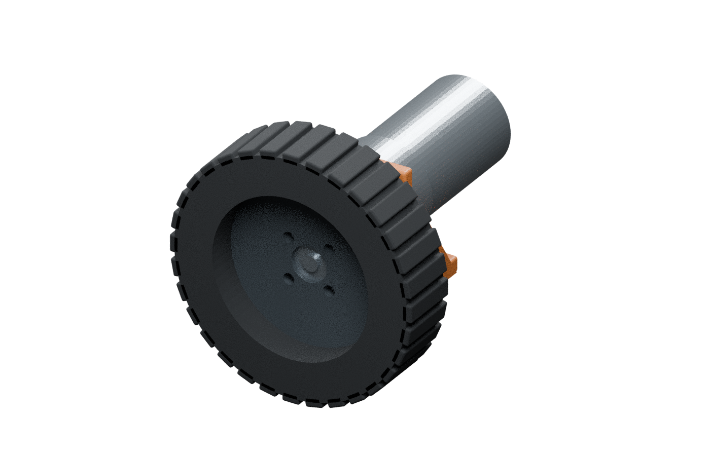
docs/manual/renders/wheel.png
