cameron5906/field4-rover/docs/history/rev-b/FIELD4_sleek_dimensions.pdf

# FIELD / 4

### Nominal assembled envelope and wheel spacing

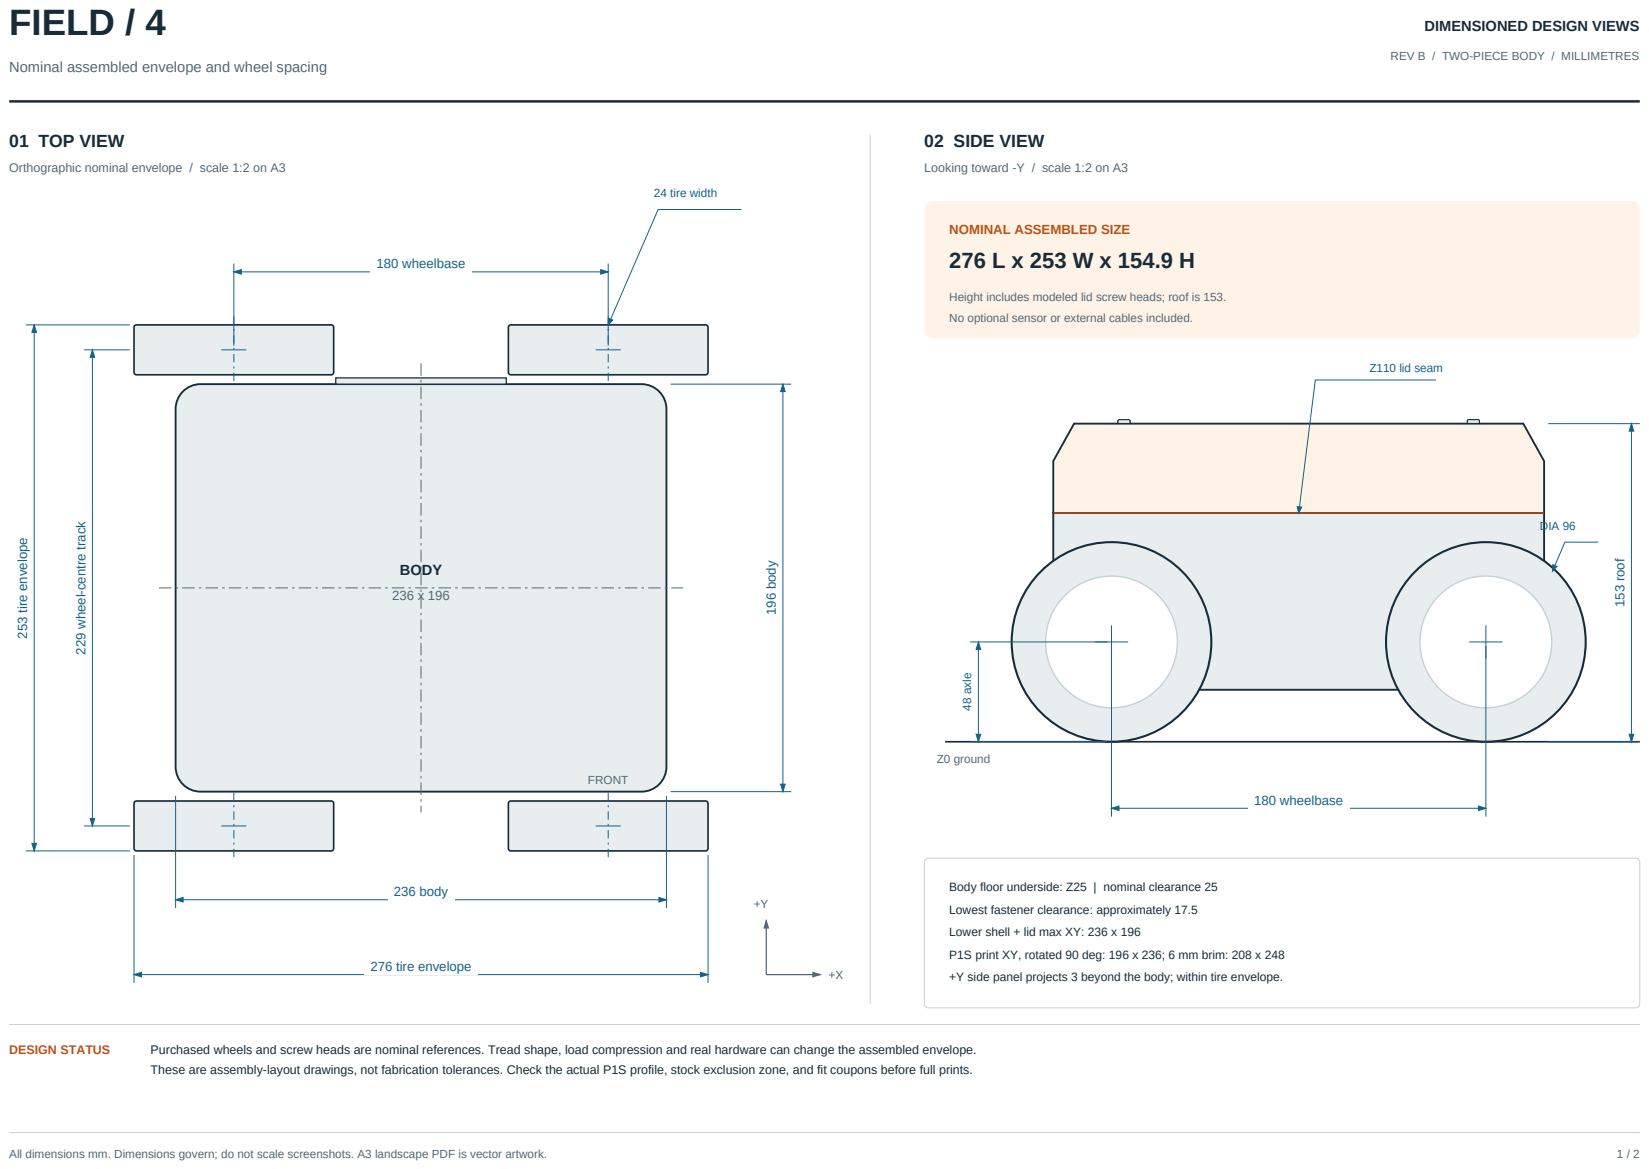
[picture p43: page 1]
01 TOP VIEW; BODY; 180 wheelbase; 236 body; 276 tire envelope; 253 tire envelope; 196 body; 24 tire width; FRONT; 02 SIDE VIEW; Z0 ground; 153 roof; 48 axle; Z110 lid seam; DIA 96; DESIGN STATUS; Purchased wheels and screw heads are nominal references. Tread shape, load compression and real hardware can change the assembled envelope.; All dimensions mm. Dimensions govern; do not scale screenshots. A3 landscape PDF is vector artwork.

DIMENSIONED DESIGN VIEWS

REV B / TWO-PIECE BODY / MILLIMETRES

Orthographic nominal envelope / scale 1:2 on A3

Looking toward -Y / scale 1:2 on A3

NOMINAL ASSEMBLED SIZE

Height includes modeled lid screw heads; roof is 153.
No optional sensor or external cables included.

229 wheel-centre track

Body floor underside: Z25 | nominal clearance 25

Lowest fastener clearance: approximately 17.5

Lower shell + lid max XY: 236 x 196

P1S print XY, rotated 90 deg: 196 x 236; 6 mm brim: 208 x 248

+Y side panel projects 3 beyond the body; within tire envelope.

These are assembly-layout drawings, not fabrication tolerances. Check the actual P1S profile, stock exclusion zone, and fit coupons before full prints.

# FIELD / 4

### Battery reserve and Raspberry Pi 4 mounting interface

### DIMENSIONED DESIGN VIEWS

REV B / TWO-PIECE BODY / MILLIMETRES

## 03 BATTERY POCKET / RESERVE

Unverified pack allowance; measure the actual battery

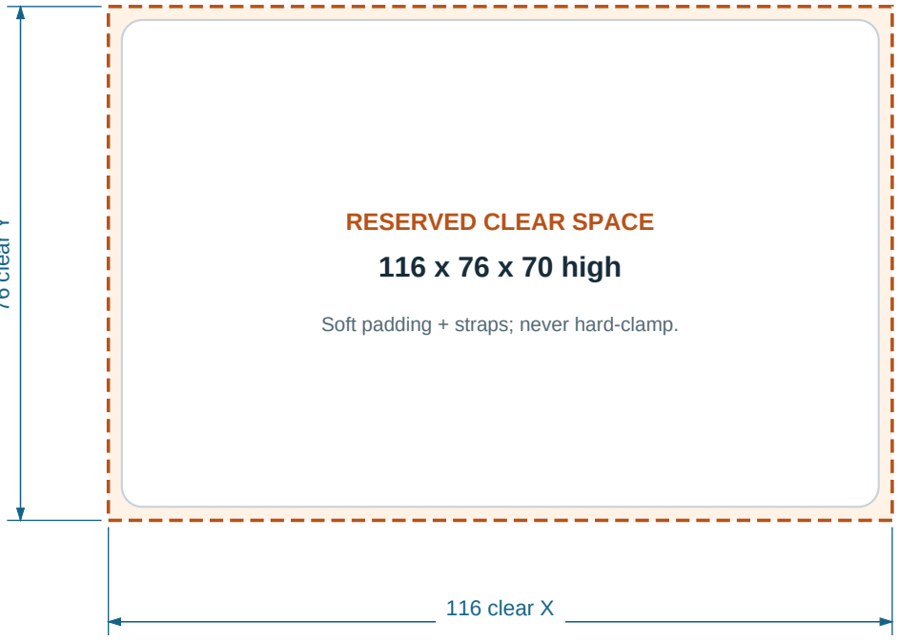
[picture p44: figure]
RESERVED CLEAR SPACE; 116 x 76 x 70 high; 116 clear X

Soft padding + straps; never hard-clamp.

76 clear Y

+X

+Y

TOP VIEW / scale 1:1 on A3

### HEIGHT SECTION

Scale 1:2 on A3; no cable/connector fit implied 70 reserved height

8.5 nominal gap
Shelf underside Z108

Reserve top Z99.5

Floor top Z29.5

Connector exits, padding and strap thickness must be checked on the real pack.

Reserve is centered at world X0, Y0. Light outline is an illustrative battery only.

## 04 RASPBERRY PI 4 INTERFACE

Top view / scale 1:1 on A3 / all coordinates are world XY

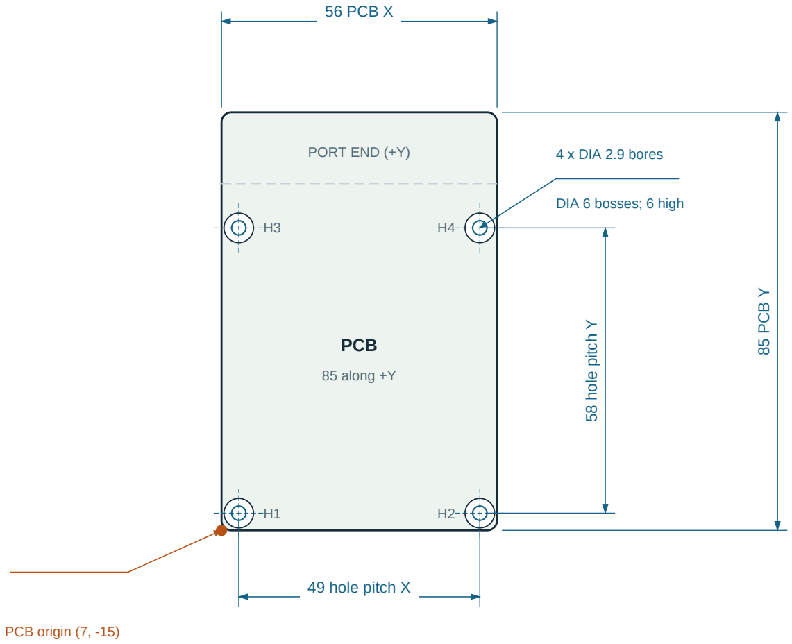
[picture p45: figure]
PORT END (+Y); PCB; 85 along +Y; 56 PCB X; 85 PCB Y; 49 hole pitch X; 58 hole pitch Y; 4 x DIA 2.9 bores; DIA 6 bosses; 6 high; PCB origin (7, -15)

MOUNTING-HOLE CENTRES

Hole | World X | World Y | PCB-edge offsets (X, Y)
H1 | 10.5 | -11.5 | 3.5, 3.5
H2 | 59.5 | -11.5 | 52.5, 3.5
H3 | 10.5 | 46.5 | 3.5, 61.5
H4 | 59.5 | 46.5 | 52.5, 61.5

Seat top Z118; PCB thickness 1.6. Four M2.5 fasteners.

Pitch is 58 along Y x 49 along X. Boss bores are printed clearances.

Verify the actual board revision, screw length, plugs and cooler before assembly.

Axes: +X forward, +Y left, +Z up. Board origin is its lower-X/lower-Y corner.

All dimensions mm. Dimensions govern; do not scale screenshots. A3 landscape PDF is vector artwork. | 2 / 2
