cameron5906/field4-rover/docs/history/rev-b/FIELD4_sleek_envelope_dimensions.png

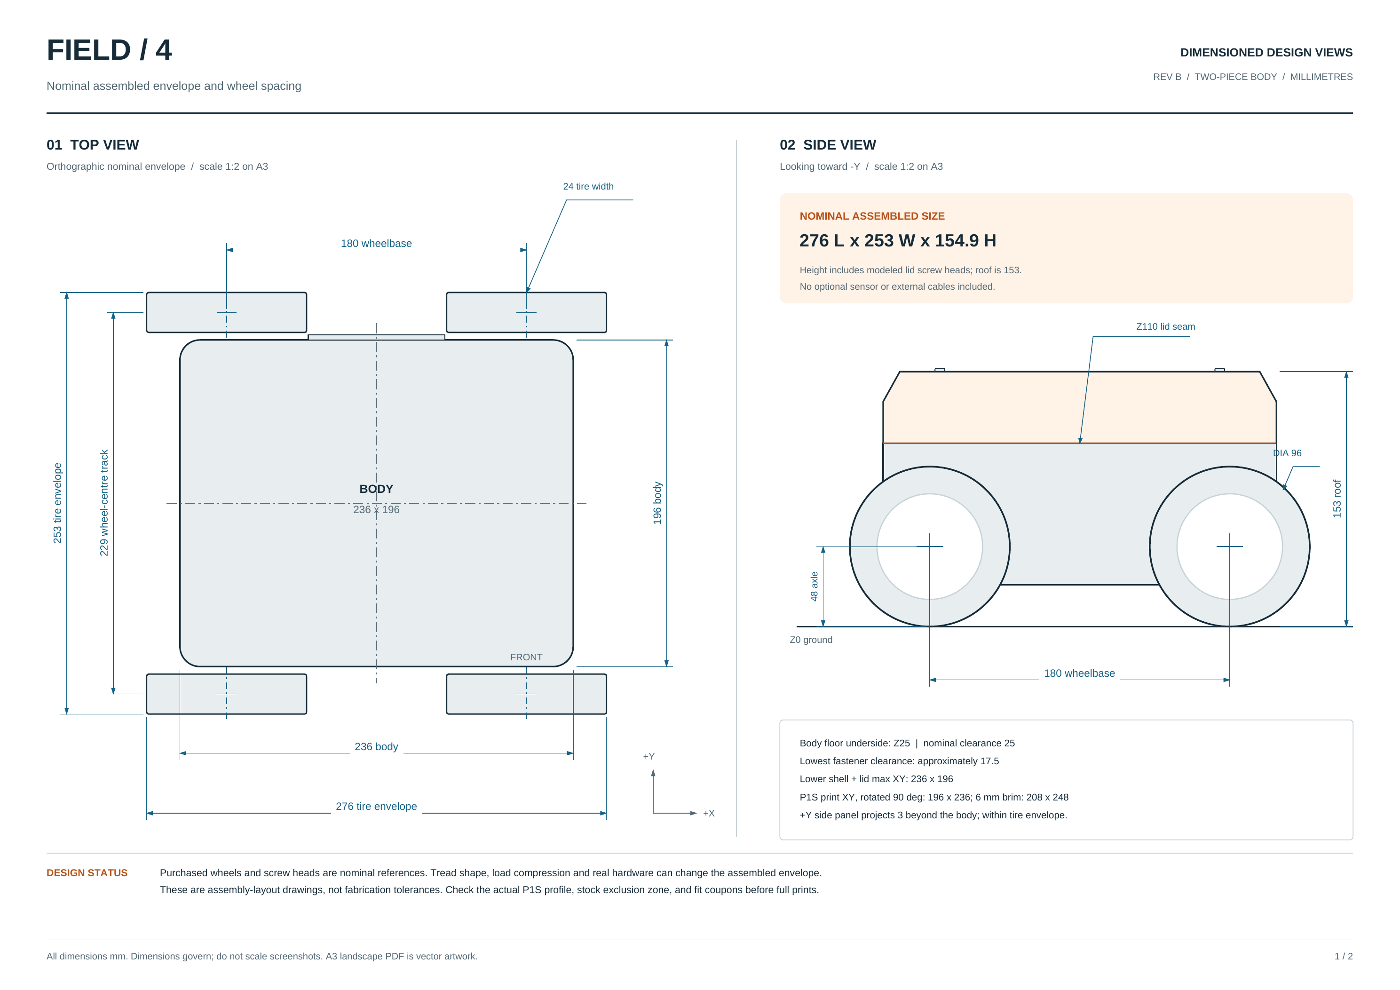
docs/history/rev-b/FIELD4_sleek_envelope_dimensions.png
