cameron5906/field4-rover/docs/history/rev-b/sleek_exploded.png

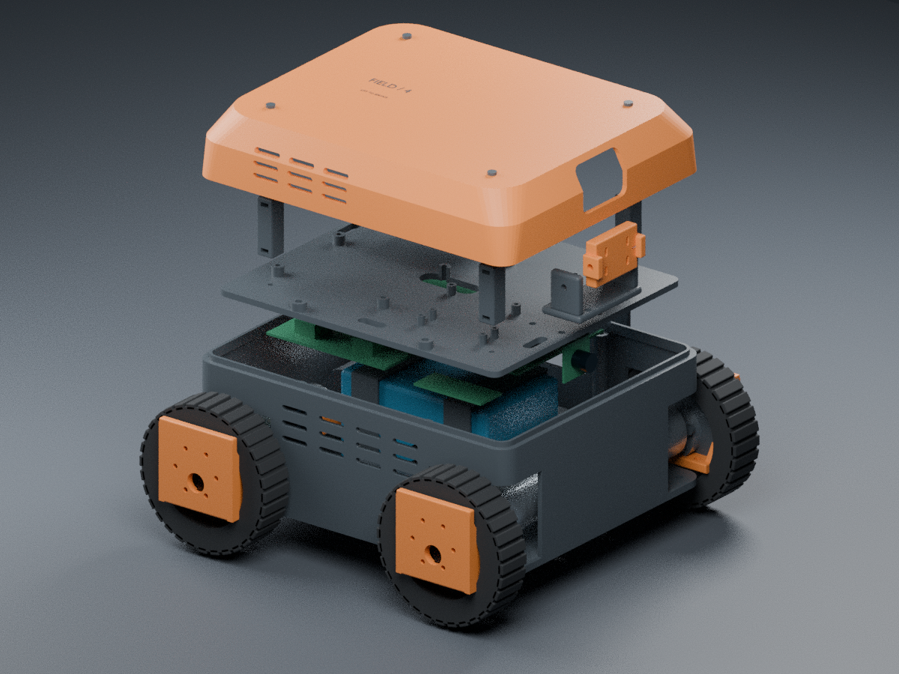
docs/history/rev-b/sleek_exploded.png
