cameron5906/field4-rover/docs/history/rev-b/sleek_internal_seats.png

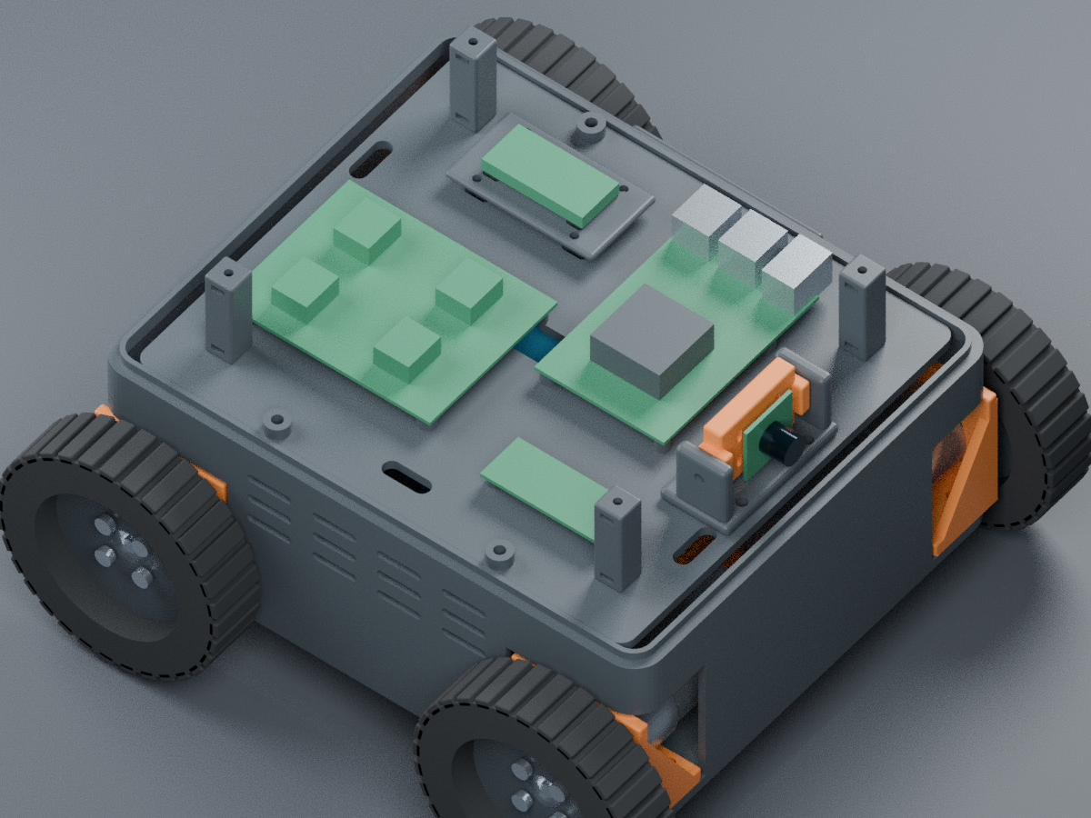
docs/history/rev-b/sleek_internal_seats.png
